skysurfer-h/WaterLevelMonitoring/README.md

# WaterLevelMonitoring
一种低成本的无线液位监控系统

注意事项：  
1.还存在不少bug，但不影响基本功能的使用。  
2.很久之前写的代码，一坨代码，很差，请谅解。  
  
技术性注意事项&存在的问题：  
软件：  
1.通信距离有限（大概穿墙20米），不适合远距离使用。  
2.测量端和控制端的【信道选择功能】已完成（【程序-2021】），监控端还未加入。  
3.【程序-2021】监控端新写的蜂鸣器相关程序未经过验证。  
4.视频中使用的程序为【程序-2019】的监控端程序，【程序-2021】的测量端和控制端程序。  
硬件：  
1.PCB为自动布线+简单手动调整。  
2.监控端PCB，二极管封装反了，待修改，焊接时需注意。  
3.控制端，原理图已将原来三极管驱动改为场效应管驱动，PCB待修改。  
4.监控端外壳右上角螺母孔有问题，螺母无法放入，待修改，其他三个螺母孔正常。建议修改为使用自攻螺丝。  
  
bilibili@skysurfer_h
