skysurfer-h/WaterLevelMonitoring/选型等.pdf

## 02 章节 PART

## TWO

# 系统总体设计

方案

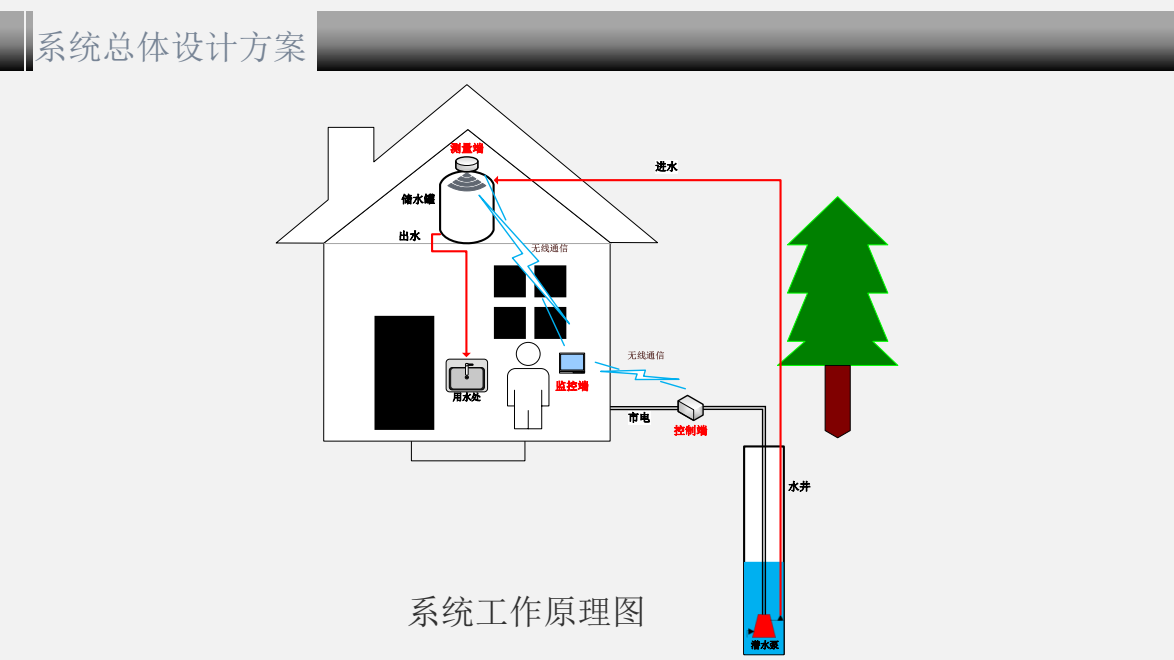
[picture p1: page 2]
控制端; 储水罐; 测量端; 监控端; 用水处; 潜水泵; 系统总体设计方案; 系统工作原理图

硬件总体设计方案

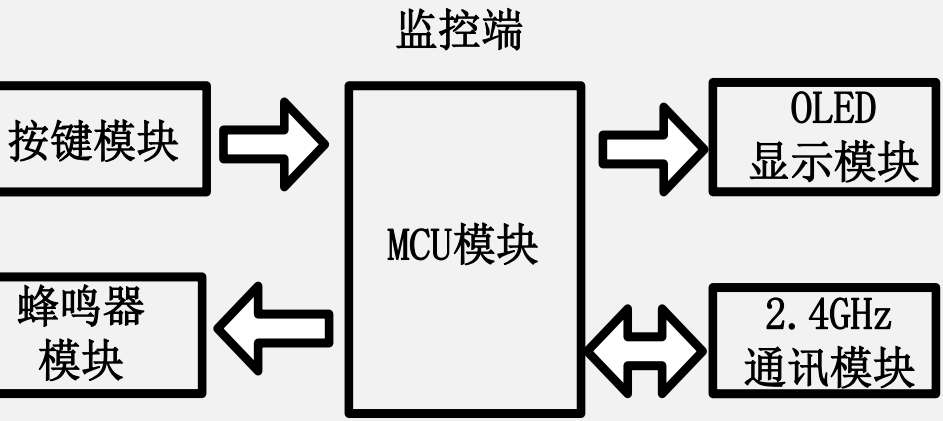
[picture p2: figure]
MCU模块; OLED 显示模块; 2.4GHz 通讯模块; 按键模块; 蜂鸣器 模块; 监控端
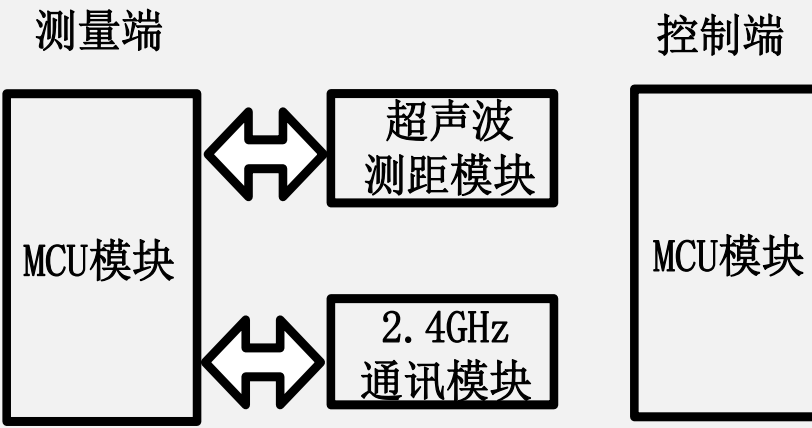
[picture p3: figure]
MCU模块; 超声波 测距模块; 2.4GHz 通讯模块; 测量端; 控制端

系统硬件框图

继电器
驱动模块

2.4GHz
通讯模块

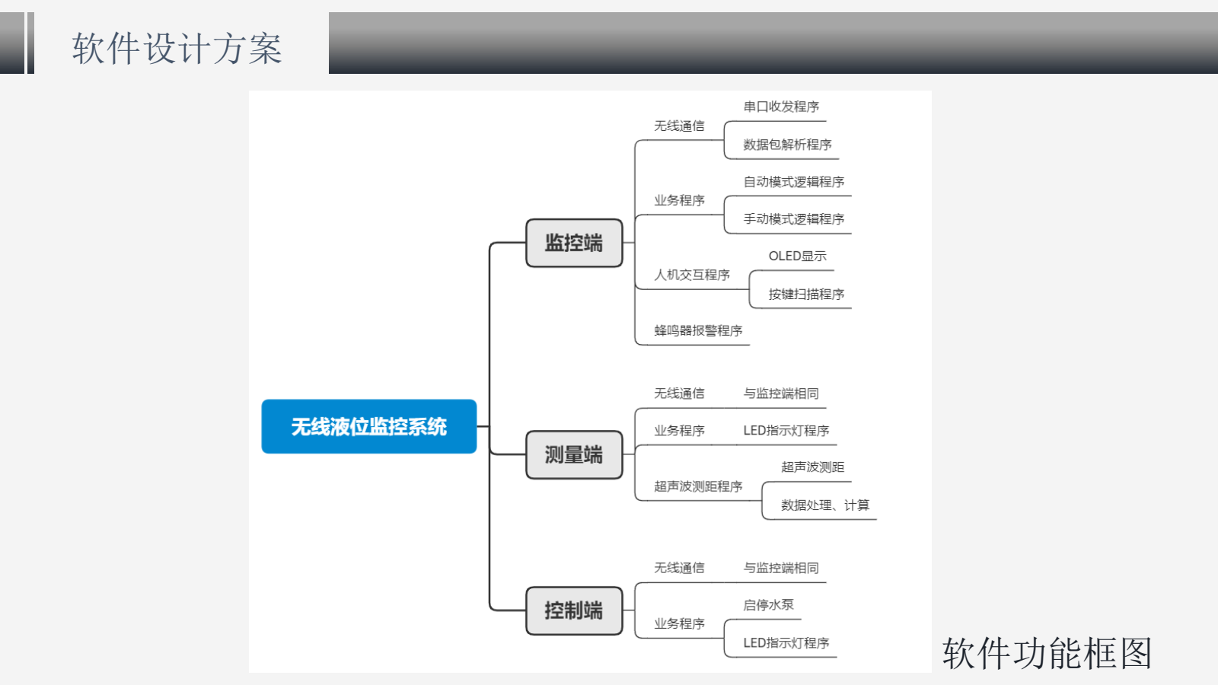
[picture p4: page 4]

软件设计方案

软件功能框图

## 03 章节 PART

## THERE

# 系统硬件设计

3.1 MCU模块

本设计三部分均采用了 STC 公司生产的
STC8F2K16S2型号单片机，采用TSSOP20封装。针 对本项目其有以下优点：
1. 内置高精度可调时钟。
2. 带有硬件IIC，方便控制OLED屏等外设。
3. 可使用USB直接下载程序无需任何外围芯片。
4. 2.0-5.5V宽工作电压。
5. 带有丰富的定时器、中断系统、ADC等。
6. 有大量实际应用，可靠性较高。成本极低。

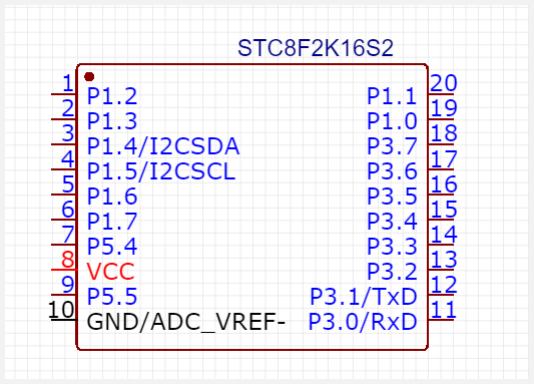
[picture p5: figure]

STC8F2K16S2原理图

3.2 无线通信模块

监控端、测量端、控制端之间的无线通信采
用LC12S串口透传模块，LC12S是深圳市凌承芯电 子有限公司生产的无线串口通信模块。针对本项
目其优点如下：
1. 2.4G频段，可设置128个信道。
2. 通讯距离为视距120米，满足目前应用场景。
3. 采用串口透明传输，开发方便。
4. 有大量实际应用，可靠性较高。

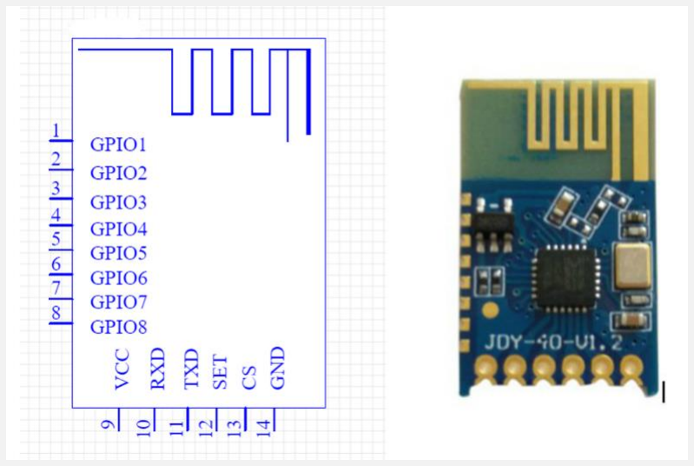
[picture p6: figure]

5. 采购成本低。 LC12S无线通讯模块原理图和实物图

3.3 监控端硬件设计

采用驱动芯片为SSD1306的OLED屏幕
作为显示模块，采用IIC与单片机进行通
信，具有自发光、体积小巧、外围电路简
单的特点，用于监控端显示当前系统状态
、液位数据、提示信息、菜单等。

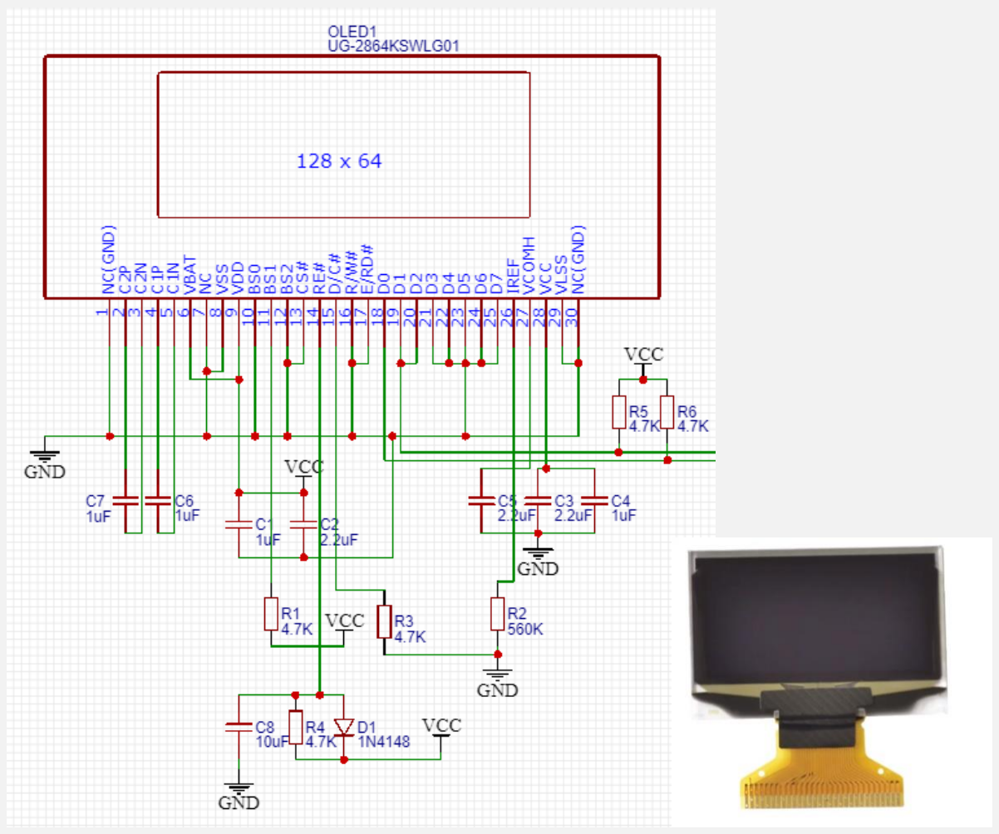
[picture p7: figure]

OLED屏幕外围电路及实物图

3.3.1 OLED显示模块

3.3 监控端硬件设计

采用Micro USB接口输入5V电源，使
用AMS1117实现降压至3.3V，为MCU和无线
通讯模块供电。

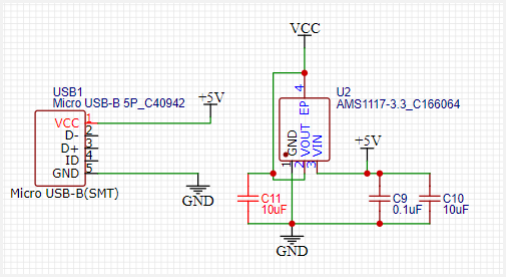
[picture p8: figure]

监控端电源模块电路原理图

3.3.2 电源模块

3.3 监控端硬件设计

采用SS8550三极管驱动有源蜂鸣器
，因蜂鸣器为感性元件，反向并联二极
管1N4148保护电路。

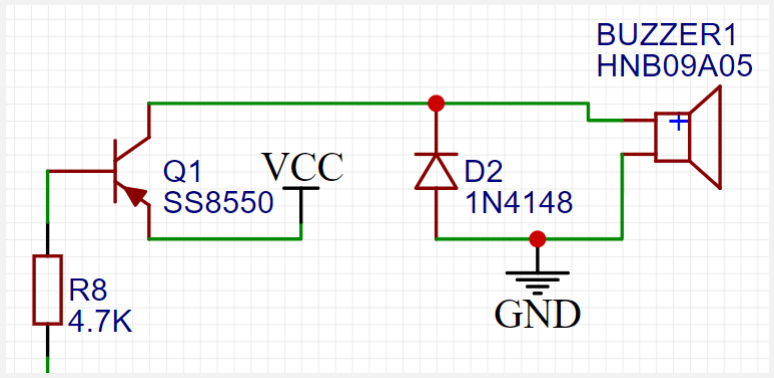
[picture p9: figure]

蜂鸣器模块电路原理图

3.3.3 蜂鸣器模块

3.3 监控端硬件设计

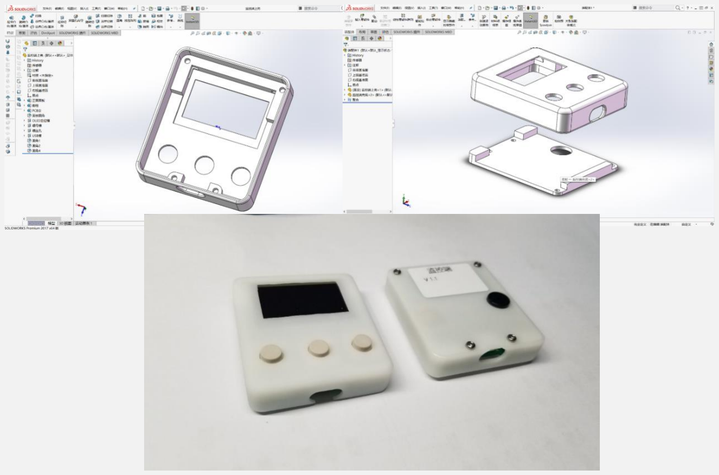
[picture p10: figure]

监控端外壳设计图及实物图

3.3.5 监控端外壳

采用SolidWorks绘制监控端
外壳，使用光固化3D打印机制作
了实物。
监控端外壳分为上壳和后盖
，根据PCB外形设计主体外形，
根据OLED的规格尺寸、按键的规
格尺寸设计了对应的PCB安装台
，根据蜂鸣器的规格尺寸在后盖
上设计了开孔，根据micro USB
数据线的外形规格设计了对应的
开孔。两部分外壳及PCB通过四
颗螺丝连接固定。

3.4 测量端硬件设计

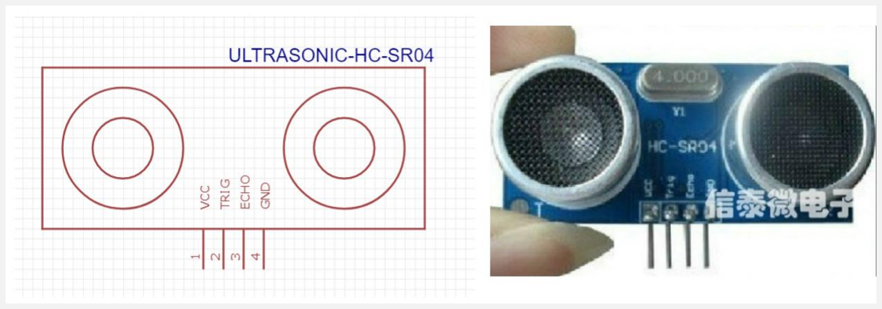
[picture p11: figure]

超声波测距模块原理图及实物图

3.4.1 超声波测距模块

采用HC-SR04超声波测距模块，
针对本项目优点：
1. 探测距离为2cm-450cm，精度为
3mm，性能满足要求。
2. 使用电压为5V，方便与本项目所
使用单片机连接开发使用。
3. 应用较多，有大量资料供参考。
4. 低成本。

3.4 测量端硬件设计

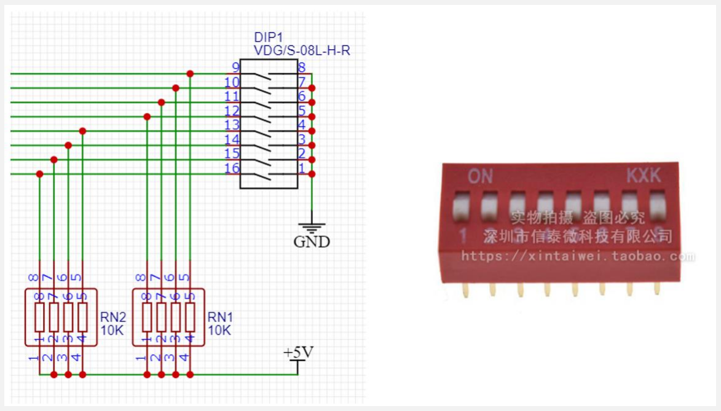
[picture p12: figure]

信道选择模块原理图及实物图

3.4.3 信道选择模块

采用拨码开关选择信道，上电
后MCU读取拨码开关数据，设置通讯
模块的频道，实现同一区域内多套
设备同时工作相互不干扰的作用。

3.5 控制端硬件设计

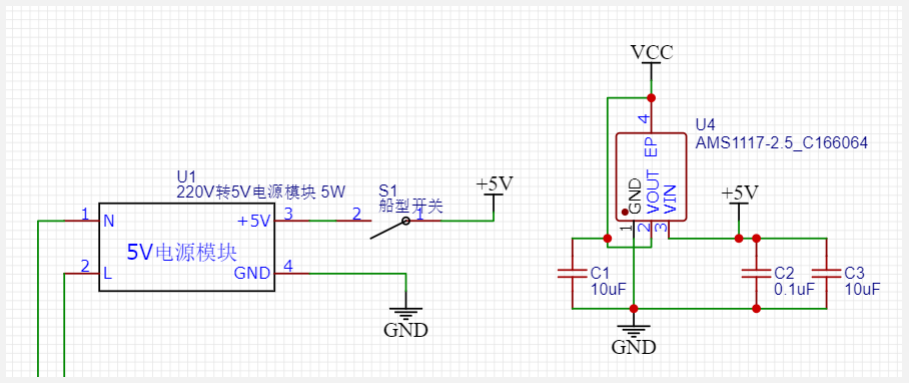
[picture p13: figure]

控制端电源部分电路图

3.5.1 电源部分

控制端电源部分采用了一个
220V转5V模块为继电器供电等，同
时使用了AMS1117将5V降压至3.3V给
无线通讯模块和MCU供电。

## 04 章节 PART

## FOUR

# 系统软件设计

4.1 监控端软件设计

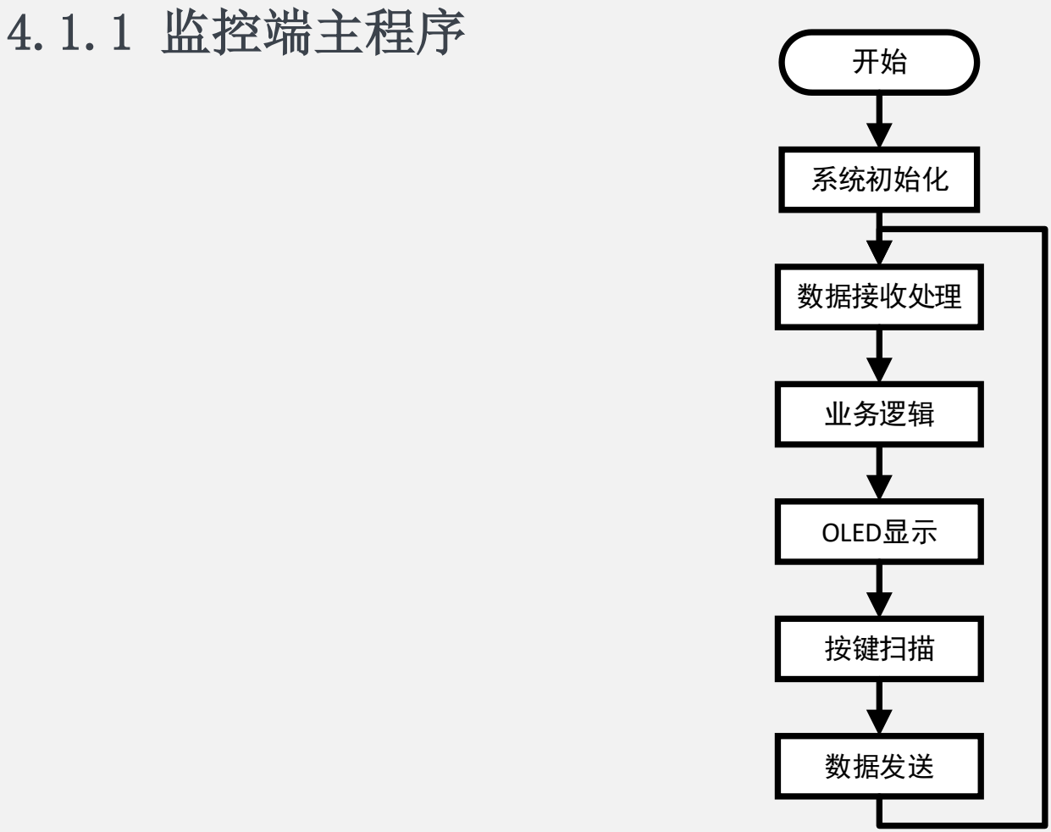
[picture p14: figure]
4.1.1 监控端主程序; 系统初始化; 数据接收处理; 业务逻辑; OLED显示; 按键扫描; 数据发送

测量端主程序流程图

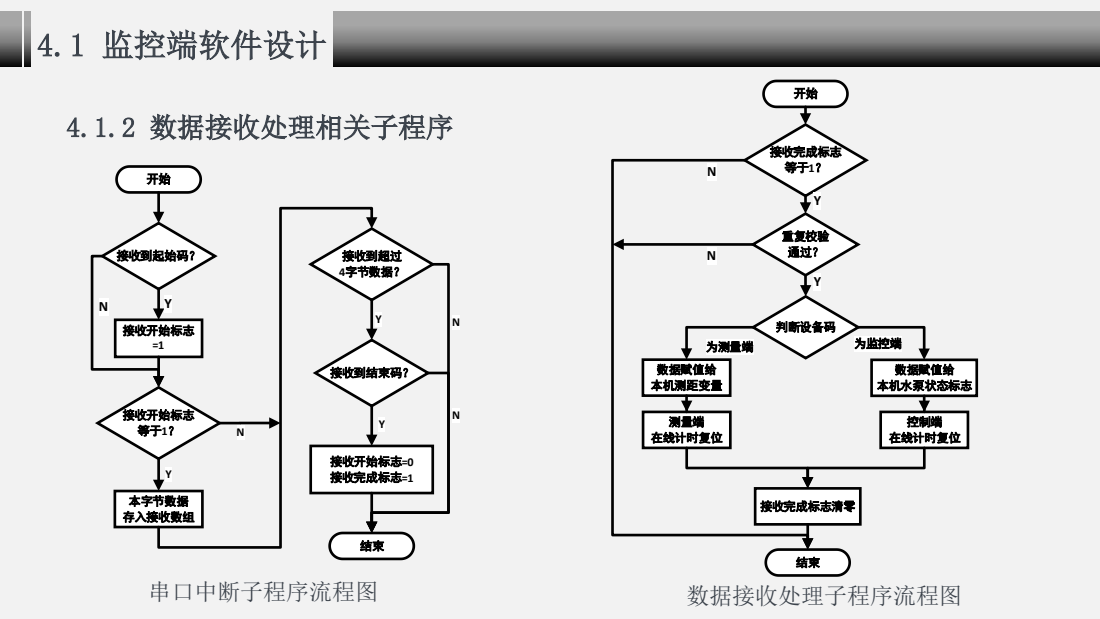
[picture p15: page 17]
4.1 监控端软件设计; 串口中断子程序流程图; 4.1.2 数据接收处理相关子程序; 接收到起始码？; 接收开始标志 =1; 接收开始标志 等于1？; 本字节数据 存入接收数组; 接收到超过 4字节数据？; 接收到结束码？; 接收开始标志=0 接收完成标志=1; 接收完成标志 N 等于1？; 重复校验 通过？; 判断设备码; 数据赋值给 本机测距变量; 为测量端; 测量端 在线计时复位; 数据赋值给 本机水泵状态标志; 控制端 在线计时复位; 为监控端; 接收完成标志清零; 数据接收处理子程序流程图

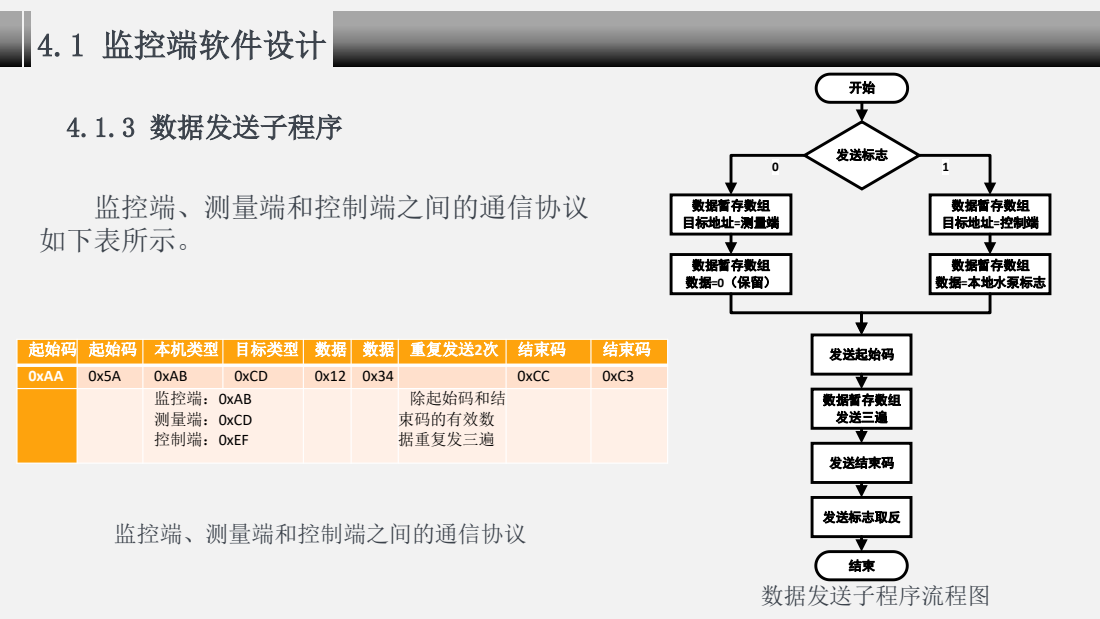
[picture p16: page 18]
4.1 监控端软件设计; 监控端、测量端和控制端之间的通信协议; 4.1.3 数据发送子程序; 数据发送子程序流程图; 发送标志; 数据暂存数组 目标地址=测量端; 数据暂存数组 目标地址=控制端; 数据暂存数组 数据=0（保留）; 数据暂存数组 数据=本地水泵标志; 发送起始码; 数据暂存数组 发送三遍; 发送标志取反; 发送结束码; 监控端、测量端和控制端之间的通信协议 如下表所示。

起始码 | 起始码 | 本机类型 | 目标类型 | 数据 | 数据 | 重复发送2次 | 结束码 | 结束码
0xAA | 0x5A | 0xAB | 0xCD | 0x12 | 0x34 | | 0xCC | 0xC3

监控端：0xAB 测量端：0xCD 控制端：0xEF | | | | 除起始码和结 束码的有效数 据重复发三遍

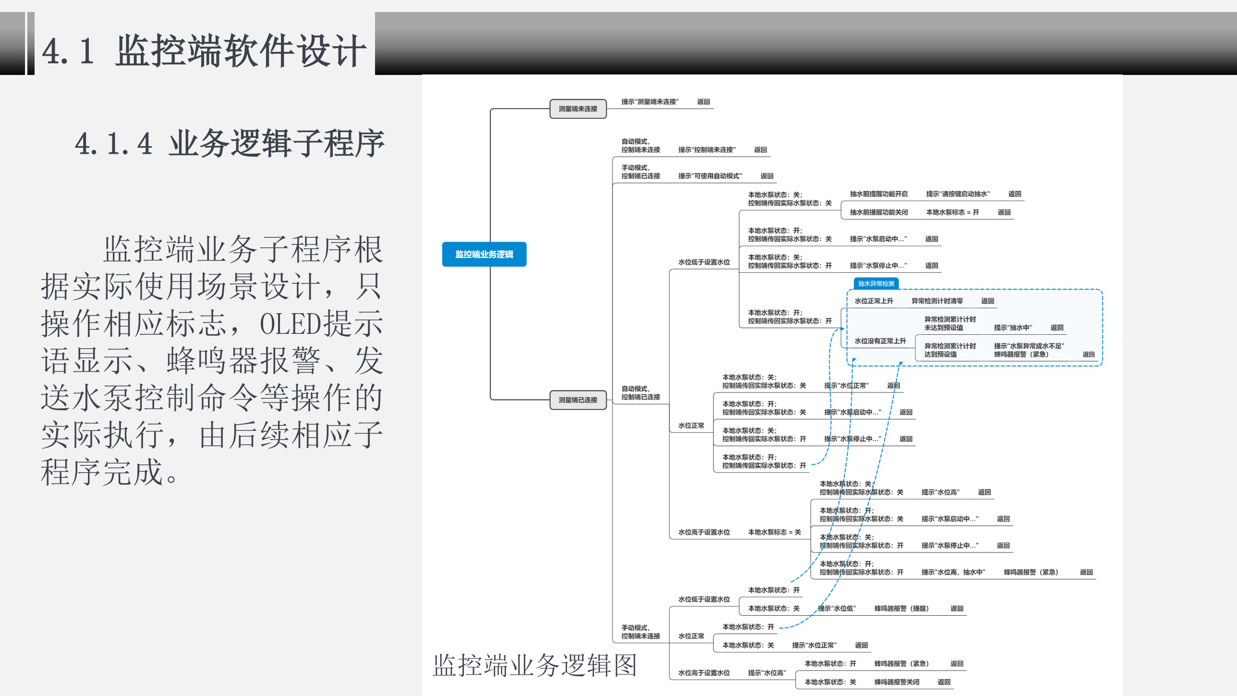
[picture p17: page 19]

4.1 监控端软件设计

4.1.4 业务逻辑子程序

监控端业务逻辑图

监控端业务子程序根
据实际使用场景设计，只
操作相应标志，OLED提示
语显示、蜂鸣器报警、发
送水泵控制命令等操作的
实际执行，由后续相应子
程序完成。

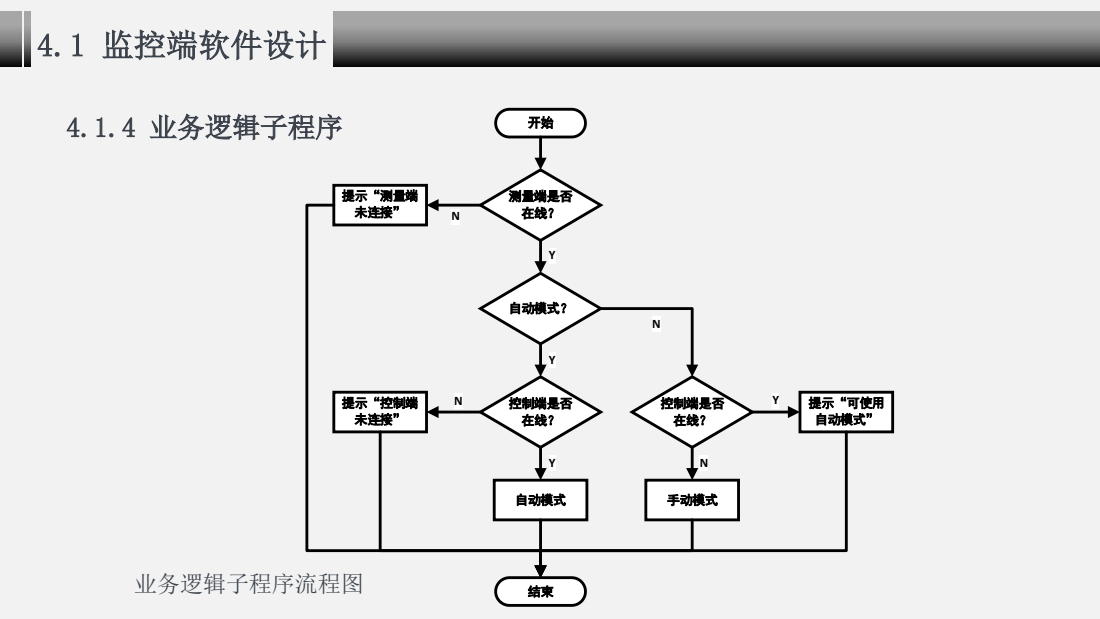
[picture p18: page 20]
测量端是否 在线？; 自动模式？; 控制端是否 在线？; 自动模式; 提示 测量端; 未连接; 提示 控制端 未连接; N 提示 可使用 自动模式; 手动模式; 4.1 监控端软件设计; 4.1.4 业务逻辑子程序; 业务逻辑子程序流程图

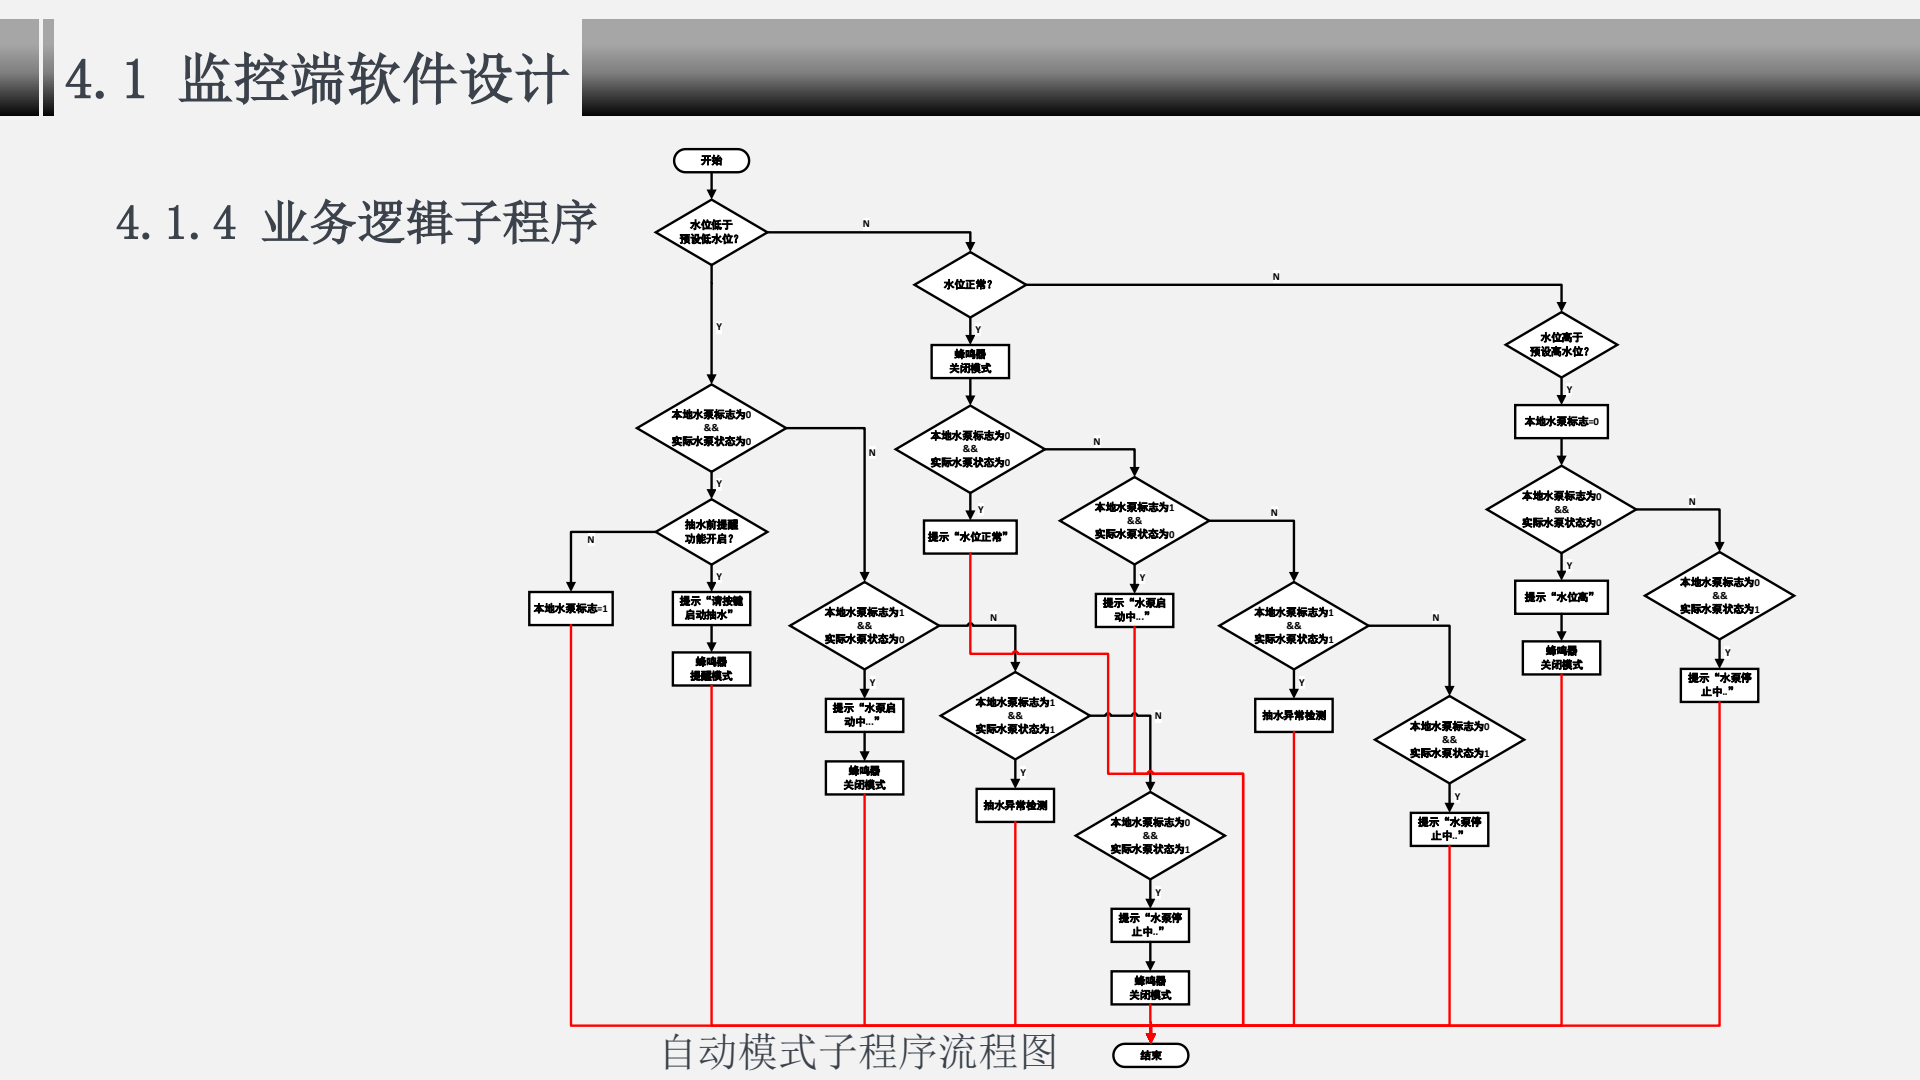
[picture p19: page 21]
水位低于 预设低水位？; 本地水泵标志为0 && 实际水泵状态为0; 抽水前提醒 功能开启？; 提示 请按键 启动抽水; 蜂鸣器 提醒模式; 本地水泵标志=1; 本地水泵标志为1 && 实际水泵状态为0; 提示 水泵启 动中...; 蜂鸣器 关闭模式; 本地水泵标志为1 && 实际水泵状态为1; 抽水异常检测; 本地水泵标志为0 && 实际水泵状态为1; 水泵停; 水位正常？; 提示 水位正常; 水位高于 预设高水位？; 本地水泵标志=0; 提示 水位高; 提示 水泵停 止中..; 4.1 监控端软件设计; 4.1.4 业务逻辑子程序; 自动模式子程序流程图

提示 水泵停 止中..

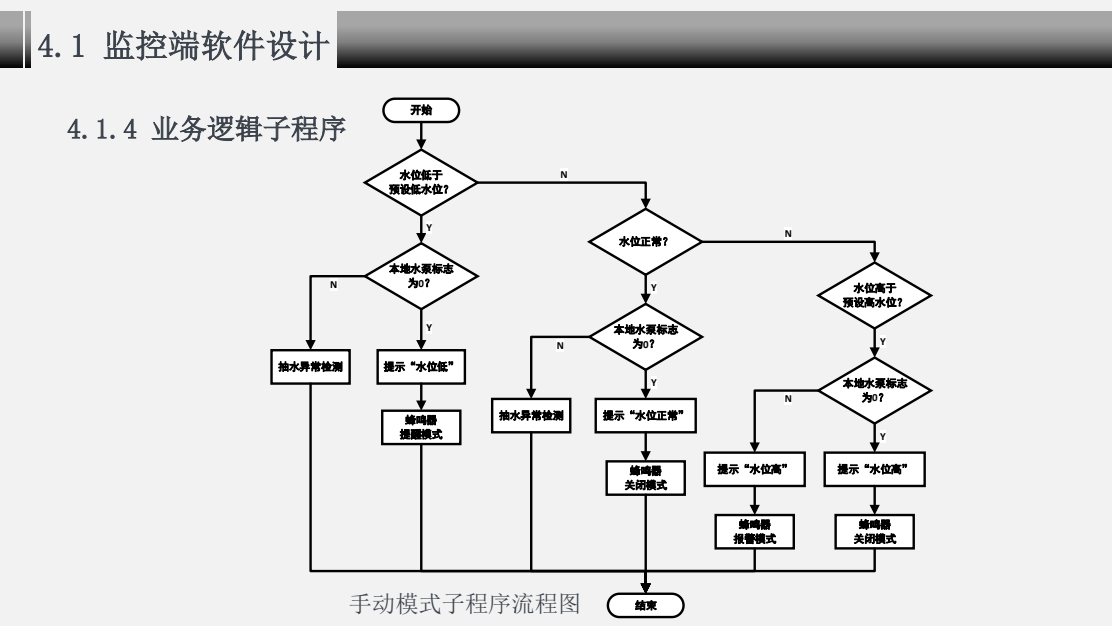
[picture p20: page 22]
水位低于 预设低水位？; 水位正常？; 本地水泵标志 为0？; 提示 水位低; 蜂鸣器 提醒模式; 抽水异常检测; 提示 水位正常; 蜂鸣器 关闭模式; 水位高于 预设高水位？; 提示 水位高; 蜂鸣器 报警模式; 4.1 监控端软件设计; 4.1.4 业务逻辑子程序; 手动模式子程序流程图

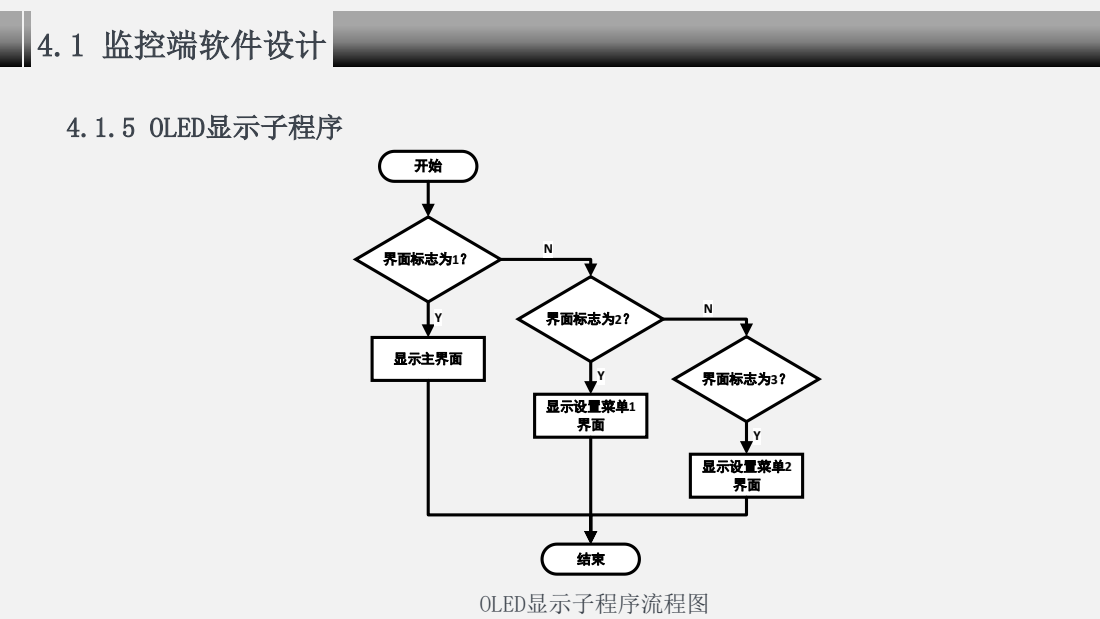
[picture p21: page 23]
4.1 监控端软件设计; 4.1.5 OLED显示子程序; OLED显示子程序流程图; 界面标志为1？; 界面标志为2？; 显示主界面; 显示设置菜单1 界面; Y 界面标志为3？; 显示设置菜单2 界面

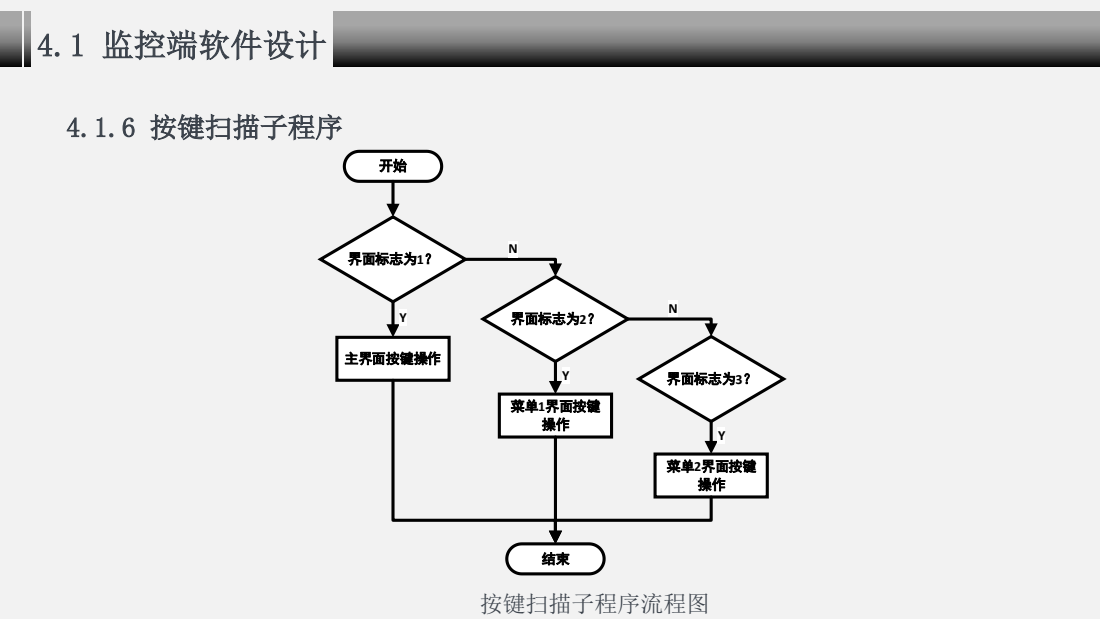
[picture p22: page 24]
4.1 监控端软件设计; 4.1.6 按键扫描子程序; 按键扫描子程序流程图; 界面标志为1？; 界面标志为2？; 主界面按键操作; 菜单1界面按键 操作; Y 界面标志为3？; 菜单2界面按键 操作

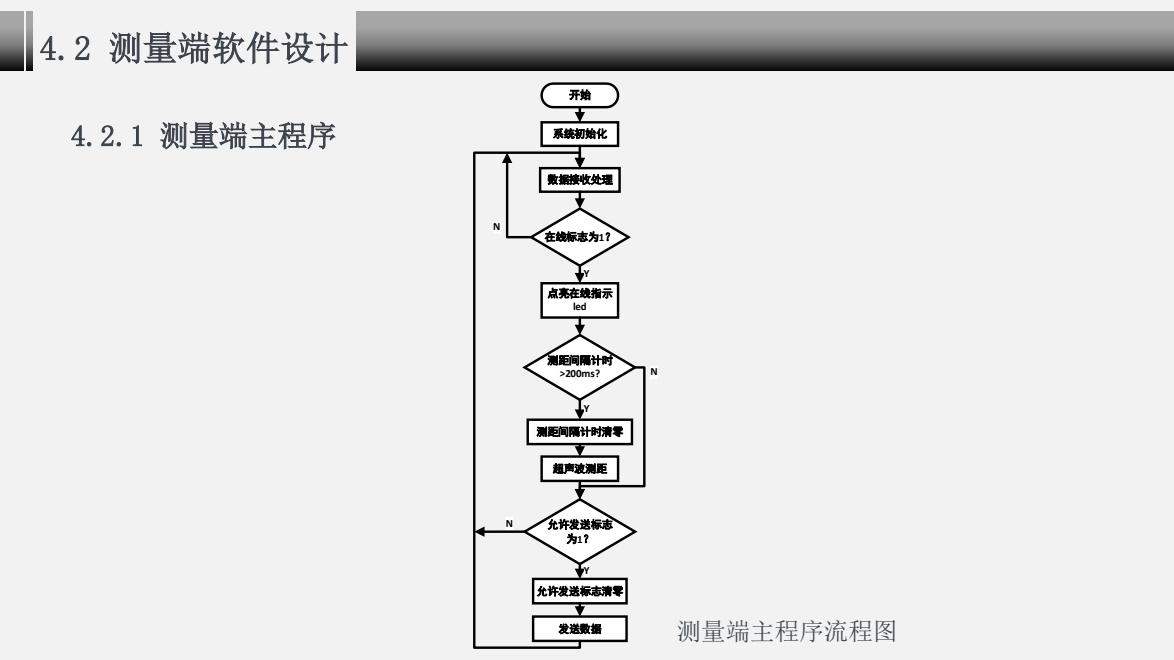
[picture p23: page 25]
4.2 测量端软件设计; 4.2.1 测量端主程序; 系统初始化; 数据接收处理; 在线标志为1？; 点亮在线指示 led; 测距间隔计时 >200ms?; 测距间隔计时清零; 超声波测距; 允许发送标志 为1？; 允许发送标志清零; 发送数据; 测量端主程序流程图

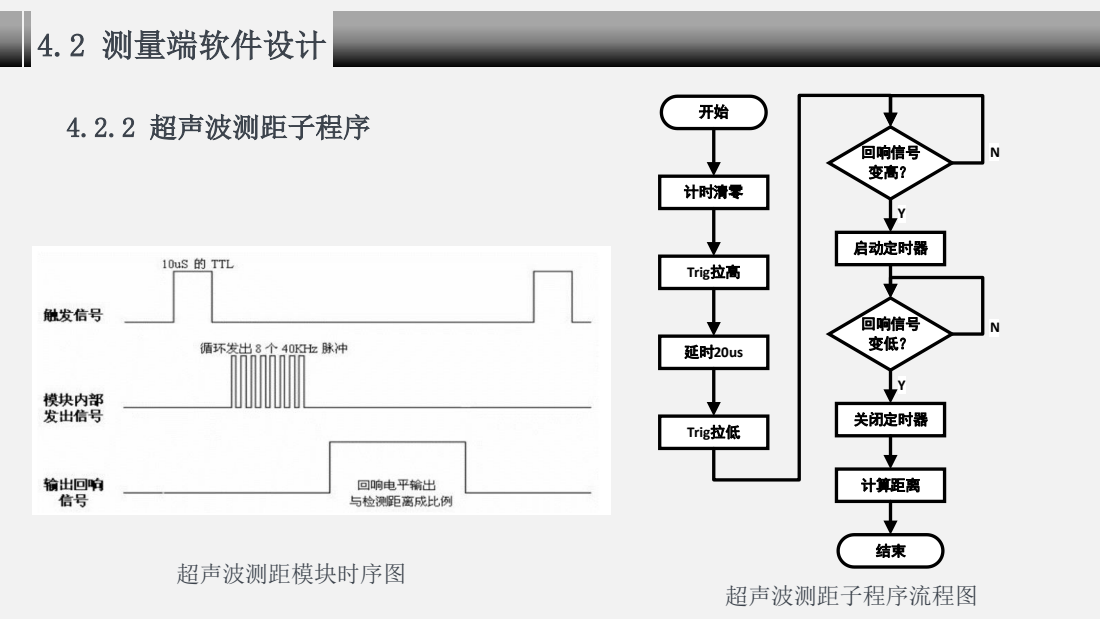
[picture p24: page 26]
4.2 测量端软件设计; 4.2.2 超声波测距子程序; 超声波测距子程序流程图; 计时清零; Trig拉高; Trig拉低; 回响信号 变高？; 启动定时器; 回响信号 变低？; 关闭定时器; 计算距离; 超声波测距模块时序图

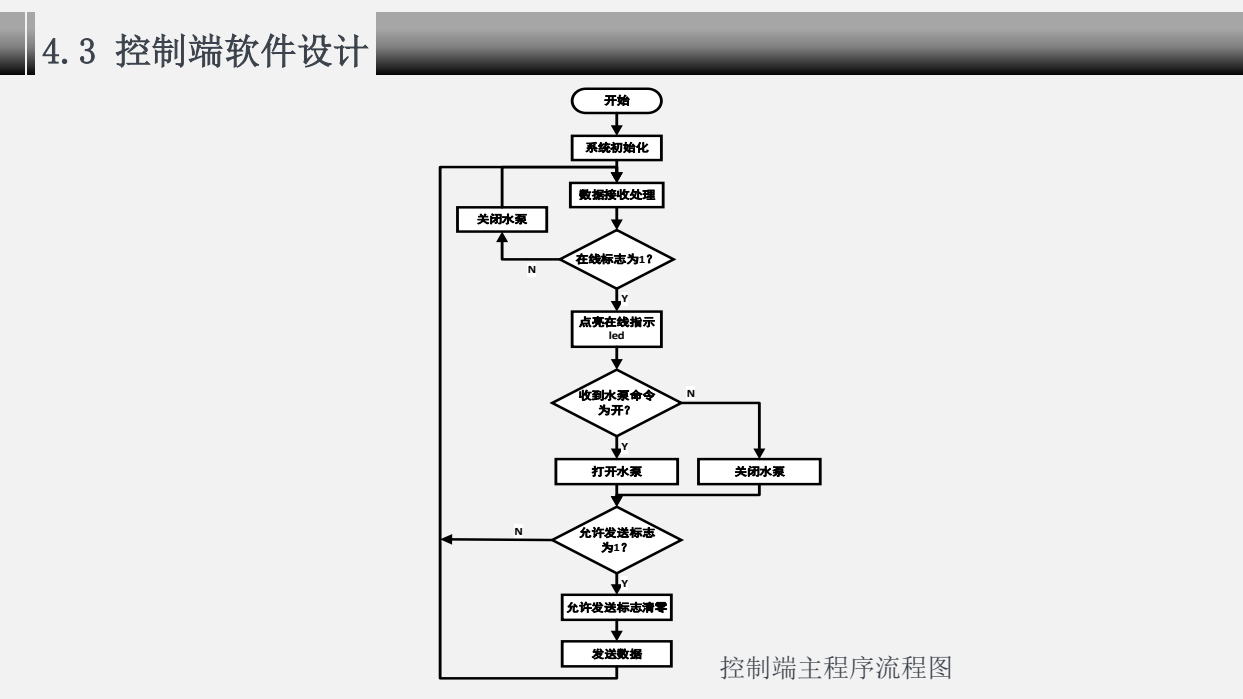
[picture p25: page 27]
系统初始化; 数据接收处理; 在线标志为1？; 点亮在线指示 led; 收到水泵命令 为开？; 打开水泵; 允许发送标志 为1？; 允许发送标志清零; 发送数据; 关闭水泵; 4.3 控制端软件设计; 控制端主程序流程图

展望

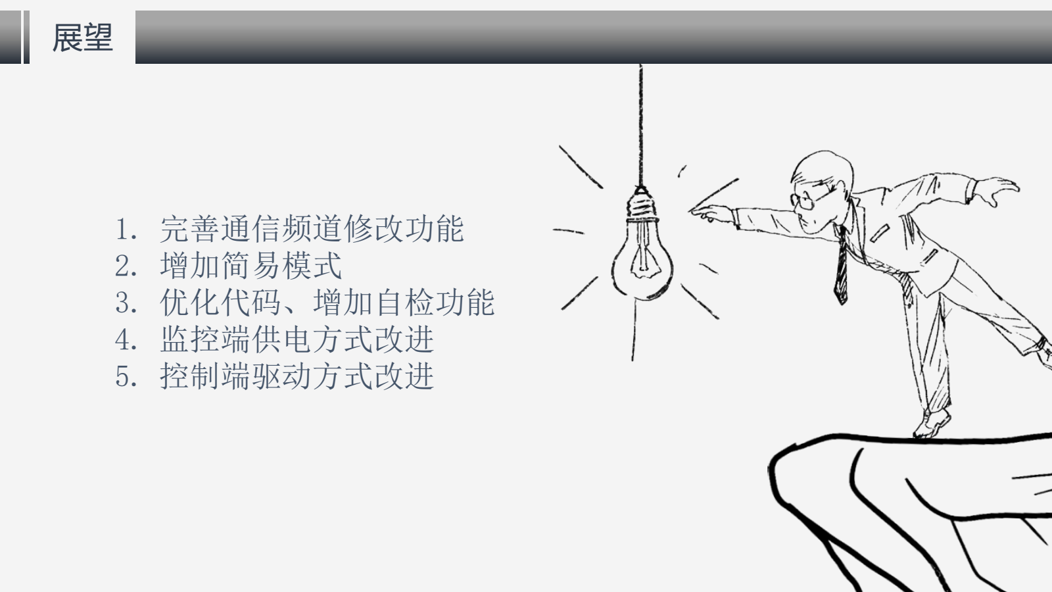
[picture p26: page 28]

1. 完善通信频道修改功能
2. 增加简易模式
3. 优化代码、增加自检功能
4. 监控端供电方式改进
5. 控制端驱动方式改进
