skysurfer-h/WaterLevelMonitoring/程序/程序-2019/stc8f2k64s2 管脚图.png

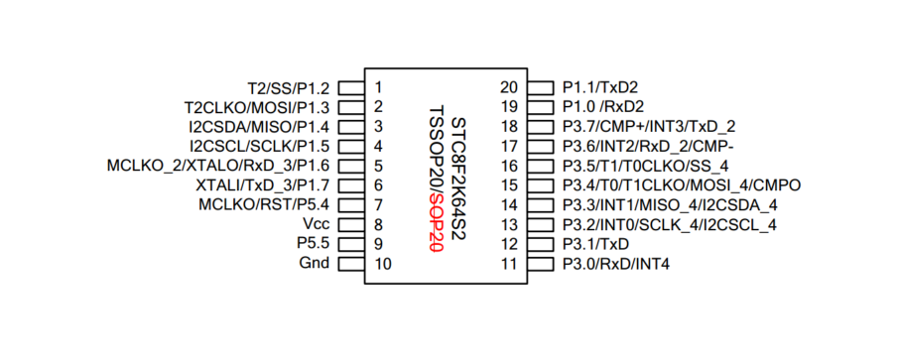
程序/程序-2019/stc8f2k64s2 管脚图.png
