skysurfer-h/WaterLevelMonitoring/程序/程序-2019/图标/20111118162344.jpg

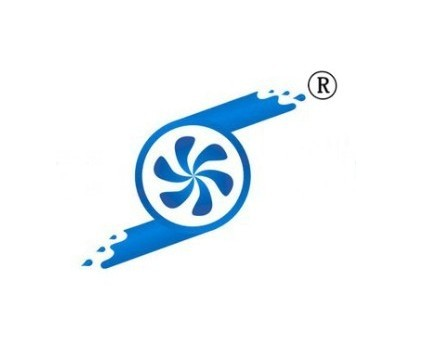
程序/程序-2019/图标/20111118162344.jpg
