skysurfer-h/WaterLevelMonitoring/程序/程序-2019/图标/u=115040544,3441267535&fm=26&gp=0.jpg

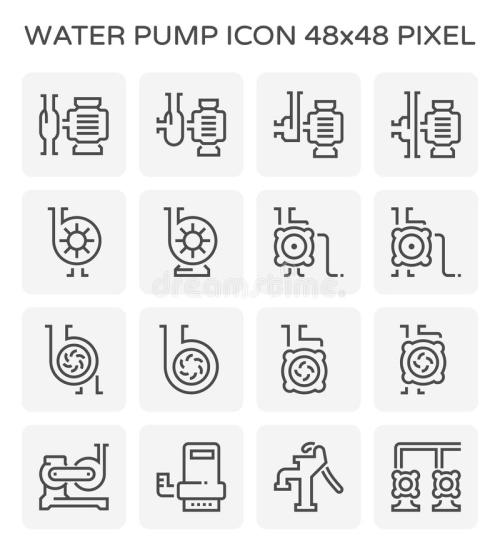
程序/程序-2019/图标/u=115040544,3441267535&fm=26&gp=0.jpg
