skysurfer-h/WaterLevelMonitoring/程序/程序-2019/图标/u=2507132996,1676860970&fm=26&gp=0.jpg

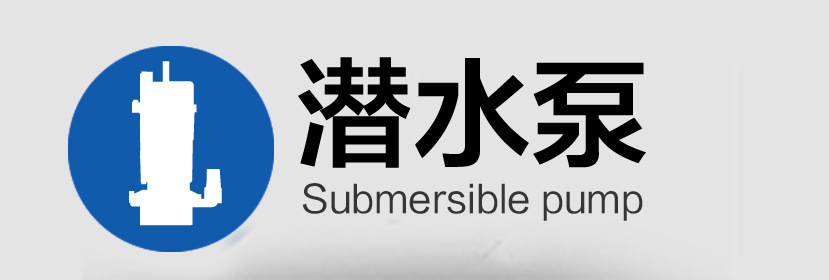
程序/程序-2019/图标/u=2507132996,1676860970&fm=26&gp=0.jpg
