skysurfer-h/WaterLevelMonitoring/程序/程序-2019/图标/水泵 图标4.jpg

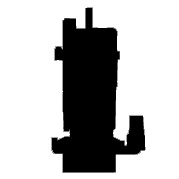
程序/程序-2019/图标/水泵 图标4.jpg
