skysurfer-h/WaterLevelMonitoring/(list of files, cad)

Other CAD files:
程序/程序-2021/01-监控端/Objects/main.obj
程序/程序-2019/01-监控端/Objects/main.obj
程序/程序-2019/02-测量端/rec51.OBJ
程序/程序-2019/03-水泵控制端/Water_pump.OBJ
程序/程序-2019/02-测量端/STARTUP.OBJ
程序/程序-2019/03-水泵控制端/STARTUP.OBJ
程序/程序-2021/01-监控端/Objects/STARTUP.obj
程序/程序-2021/01-监控端/Objects/delay.obj
程序/程序-2021/01-监控端/Objects/I2C.obj
程序/程序-2021/01-监控端/Objects/ds1302.obj
程序/程序-2021/01-监控端/Objects/font.obj
程序/程序-2021/01-监控端/Objects/SSD1306.obj
程序/程序-2021/01-监控端/Objects/GUI.obj
程序/程序-2021/01-监控端/Objects/ds18b20.obj
程序/程序-2019/01-监控端/Objects/ds1302.obj
程序/程序-2019/01-监控端/Objects/GUI.obj
程序/程序-2019/01-监控端/Objects/SSD1306.obj
程序/程序-2019/01-监控端/Objects/font.obj
程序/程序-2019/01-监控端/Objects/I2C.obj
程序/程序-2019/01-监控端/Objects/STARTUP.obj
程序/程序-2019/01-监控端/Objects/delay.obj
